jawjay/Guitar_Tuning/images/guitar_head2.png

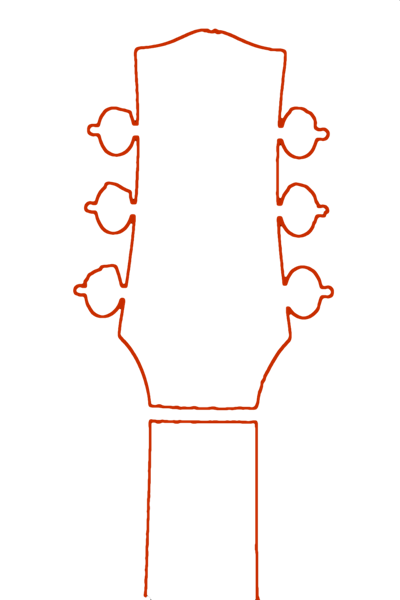
images/guitar_head2.png
