jawjay/Guitar_Tuning/images/iOS_screen.png

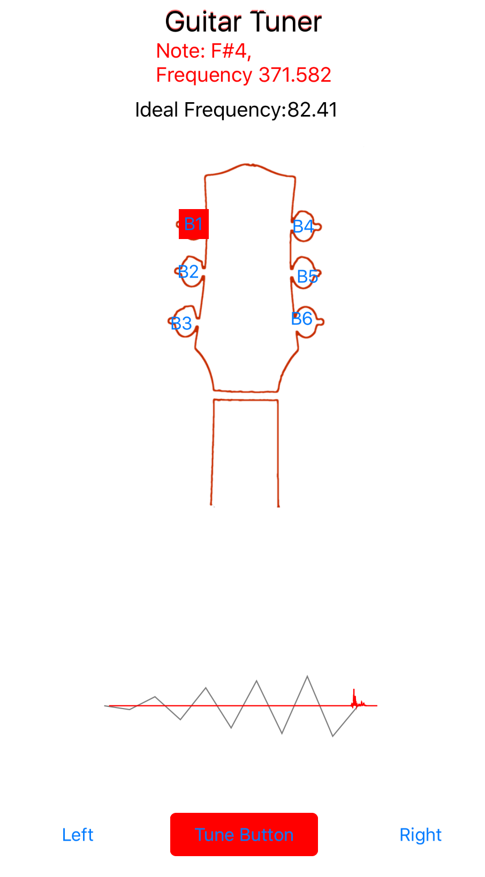
images/iOS_screen.png
