jawjay/Guitar_Tuning/images/Simulator Screen Shot May 1, 2016, 4.47.51 PM_iphone6plus_spacegrey_side1.png

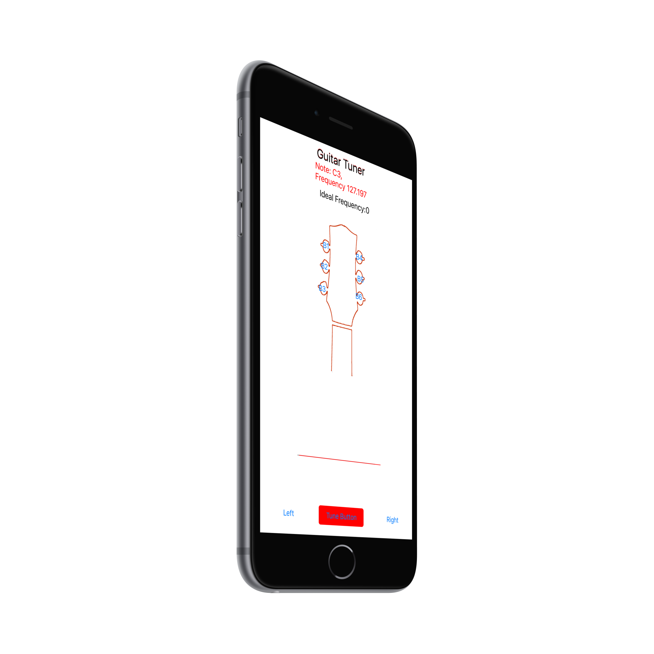
images/Simulator Screen Shot May 1, 2016, 4.47.51 PM_iphone6plus_spacegrey_side1.png
