jawjay/Guitar_Tuning/(commit log)

2016-03-27 added guitar head diagram with accompanying buttons as well as tuning button
2016-04-22 PWM via wav file, windowed FFT
